yifanwu2828/Capston-Design-Trailbot/ECE 4900 - Trailbot/Parts Data/VMA_accelerometer/vma208_scheme.pdf

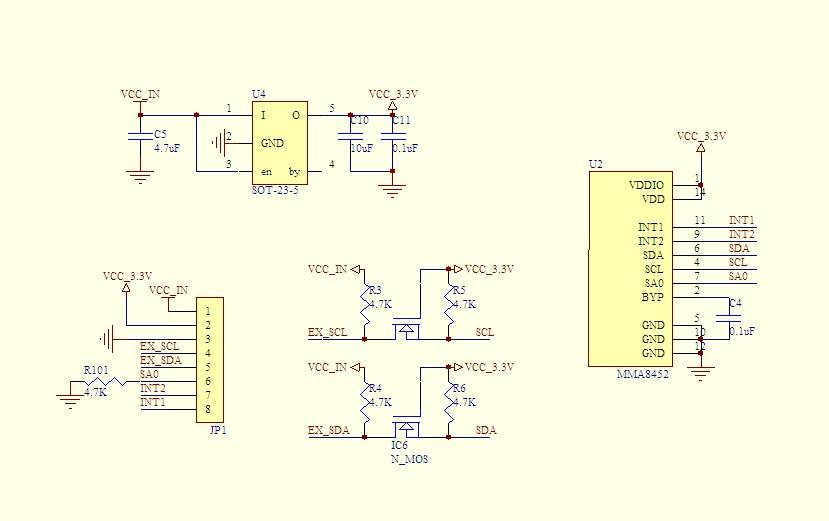
[picture p32: page 1]
